Francesco2802/UniversalTouchFreeKeypadAdaptor/Schematic/Touch-Free Keypad Adaptor/Touch-Free Keypad Adaptor rev1.0/Touch-Free Keypad Adaptor rev1.0.sch

## EAGLE design Schematic/Touch-Free Keypad Adaptor/Touch-Free Keypad Adaptor rev1.0/Touch-Free Keypad Adaptor rev1.0.sch (2020-08-30)

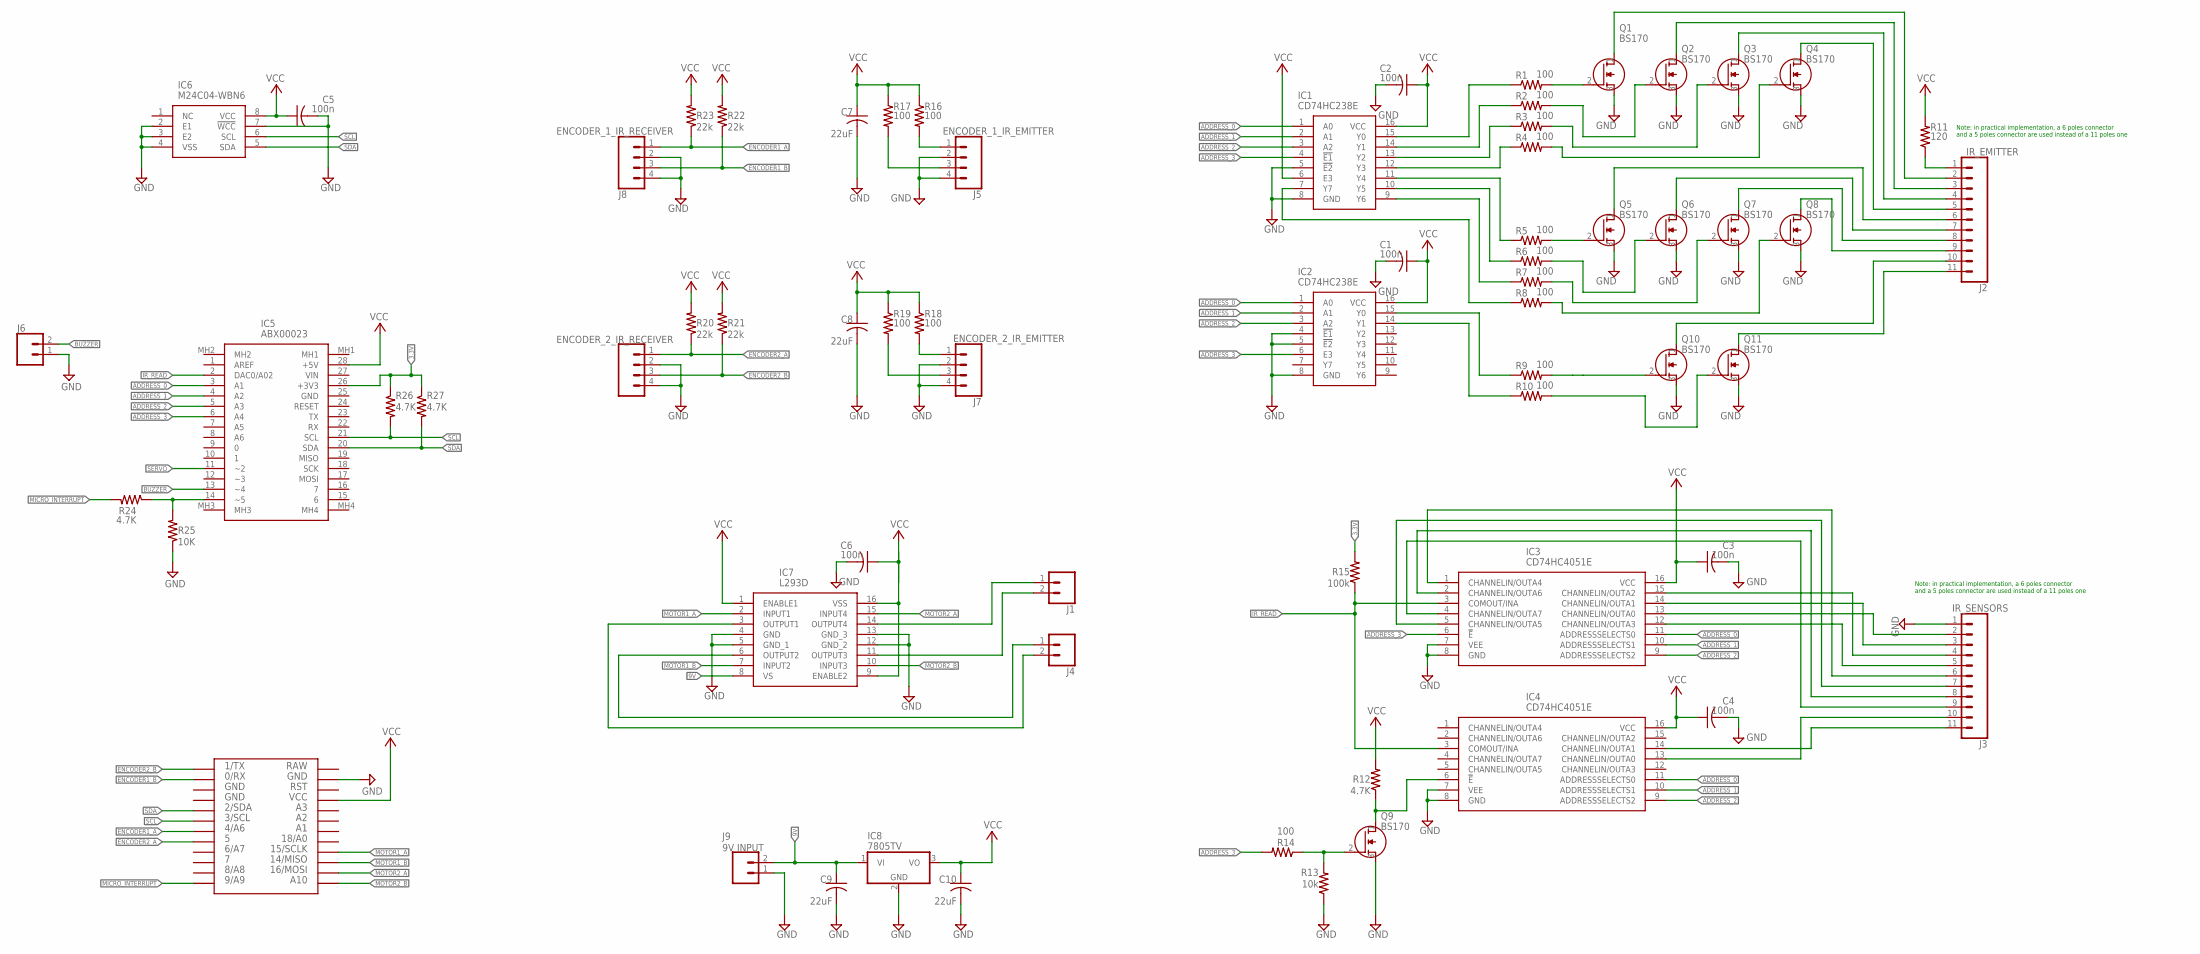
[picture p1: schematic Touch-Free Keypad Adaptor rev1.0.sch]

Parts:
C1, C2, C3, C4, C5, C6: 100n; C050-024X044
C7, C8, C9, C10: 22uF; C050-024X044
ENCODER_2_IR_RECEIVER: CONN_04; 1X04
IC1, IC2: CD74HC238E; DIP794W53P254L1930H508Q16N
IC3, IC4: CD74HC4051E; DIP794W53P254L1930H508Q16N
IC5: ABX00023
IC6: M24C04-WBN6; DIP762W56P254L959H533Q8N
IC7: L293D; DIP795W50P254L2000H510Q16N
IC8: 7805TV; TO220V
J1, J4, J6: CONN_02; 1X02
J2: IR_EMITTER; 1X11
J3: IR_SENSORS; 1X11
J5: ENCODER_1_IR_EMITTER; 1X04
J7: ENCODER_2_IR_EMITTER; 1X04
J8: ENCODER_1_IR_RECEIVER; 1X04
J9: 9V INPUT; SCREWTERMINAL-5MM-2
Q1, Q2, Q3, Q4, Q5, Q6, Q7, Q8, Q9, Q10, Q11: BS170; KA431AZTA
R1, R2, R3, R4, R5, R6, R7, R8, R9, R10, R14, R16, R17, R18, R19: 100; 0207/7
R11: 120; 0207/7
R12, R24, R26, R27: 4.7K; 0207/7
R13: 10k; 0207/7
R15: 100k; 0207/7
R20, R21, R22, R23: 22k; 0207/7
R25: 10K; 0207/7
U$31: ARDUINO_MICRO

Connections:
3.3V: IC5.26 (+3V3), R15.2, R26.1, R27.1
9V: C9.1, IC7.8 (VS), IC8.1 (VI), J9.2
ADDRESS_0: IC1.1 (A0), IC2.1 (A0), IC3.11 (ADDRESSSELECTS0), IC4.11 (ADDRESSSELECTS0), IC5.3 (A1)
ADDRESS_1: IC1.2 (A1), IC2.2 (A1), IC3.10 (ADDRESSSELECTS1), IC4.10 (ADDRESSSELECTS1), IC5.4 (A2)
ADDRESS_2: IC1.3 (A2), IC2.3 (A2), IC3.9 (ADDRESSSELECTS2), IC4.9 (ADDRESSSELECTS2), IC5.5 (A3)
ADDRESS_3: IC1.4 (!E1), IC2.6 (E3), IC3.6 (!E), IC5.6 (A4), R14.2
BUZZER: IC5.13 (~4), J6.2
ENCODER1_A: J8.1, R23.1, U$31.P$7
ENCODER1_B: J8.3, R22.1, U$31.P$2
ENCODER2_A: ENCODER_2_IR_RECEIVER.1, R20.1, U$31.P$8
ENCODER2_B: ENCODER_2_IR_RECEIVER.3, R21.1, U$31.P$1
GND: C1.2, C2.2, C3.2, C4.2, C5.2, C6.2, C7.2, C8.2, C9.2, C10.2, ENCODER_2_IR_RECEIVER.2, ENCODER_2_IR_RECEIVER.4, IC1.5 (!E2), IC1.8 (GND), IC2.4 (!E1), IC2.5 (!E2), IC2.8 (GND), IC3.7 (VEE), IC3.8 (GND), IC4.7 (VEE), IC4.8 (GND), IC6.2 (E1), IC6.3 (E2), IC6.4 (VSS), IC6.7 (!WCC), IC7.4 (GND), IC7.5 (GND_1), IC7.12 (GND_2), IC7.13 (GND_3), IC8.2 (GND), J3.1, J5.2, J5.4, J6.1, J7.2, J7.4, J8.2, J8.4, J9.1, Q1.3 (S), Q2.3 (S), Q3.3 (S), Q4.3 (S), Q5.3 (S), Q6.3 (S), Q7.3 (S), Q8.3 (S), Q9.3 (S), Q10.3 (S), Q11.3 (S), R13.1, R25.1, U$31.P$23
IR_READ: IC3.3 (COMOUT/INA), IC4.3 (COMOUT/INA), IC5.2 (DAC0/A02), R15.1
MICRO_INTERRUPT: R24.2, U$31.P$12
MOTOR1_A: IC7.2 (INPUT1), U$31.P$16
MOTOR1_B: IC7.7 (INPUT2), U$31.P$15
MOTOR2_A: IC7.15 (INPUT4), U$31.P$14
MOTOR2_B: IC7.10 (INPUT3), U$31.P$13
unnamed: J2.5, Q4.1 (D)
unnamed: J2.4, Q3.1 (D)
unnamed: J2.3, Q2.1 (D)
unnamed: J2.2, Q1.1 (D)
unnamed: J2.11, Q11.1 (D)
unnamed: J2.8, Q7.1 (D)
unnamed: J2.7, Q6.1 (D)
unnamed: J2.6, Q5.1 (D)
unnamed: J2.10, Q10.1 (D)
unnamed: J2.9, Q8.1 (D)
unnamed: Q4.2 (G), R4.2
unnamed: Q3.2 (G), R3.2
unnamed: Q2.2 (G), R2.2
unnamed: Q1.2 (G), R1.2
unnamed: Q5.2 (G), R5.2
unnamed: Q8.2 (G), R8.2
unnamed: Q7.2 (G), R7.2
unnamed: Q6.2 (G), R6.2
unnamed: Q10.2 (G), R9.2
unnamed: Q11.2 (G), R10.2
unnamed: IC1.15 (Y0), R1.1
unnamed: IC1.14 (Y1), R2.1
unnamed: IC1.13 (Y2), R3.1
unnamed: IC1.12 (Y3), R4.1
unnamed: IC1.11 (Y4), R5.1
unnamed: IC1.10 (Y5), R6.1
unnamed: IC1.9 (Y6), R7.1
unnamed: IC1.7 (Y7), R8.1
unnamed: IC2.15 (Y0), R9.1
unnamed: IC2.14 (Y1), R10.1
unnamed: J2.1, R11.1
unnamed: IC3.13 (CHANNELIN/OUTA0), J3.2
unnamed: IC3.14 (CHANNELIN/OUTA1), J3.3
unnamed: IC3.15 (CHANNELIN/OUTA2), J3.4
unnamed: IC3.12 (CHANNELIN/OUTA3), J3.5
unnamed: IC3.1 (CHANNELIN/OUTA4), J3.6
unnamed: IC3.5 (CHANNELIN/OUTA5), J3.7
unnamed: IC3.2 (CHANNELIN/OUTA6), J3.8
unnamed: IC3.4 (CHANNELIN/OUTA7), J3.9
unnamed: IC4.13 (CHANNELIN/OUTA0), J3.10
unnamed: IC4.14 (CHANNELIN/OUTA1), J3.11
unnamed: J7.1, R18.2
unnamed: IC4.6 (!E), Q9.1 (D), R12.1
unnamed: Q9.2 (G), R13.2, R14.1
unnamed: IC7.14 (OUTPUT4), J1.1
unnamed: IC7.11 (OUTPUT3), J1.2
unnamed: IC7.6 (OUTPUT2), J4.1
unnamed: IC7.3 (OUTPUT1), J4.2
unnamed: J5.1, R16.2
unnamed: J5.3, R17.2
unnamed: J7.3, R19.2
unnamed: IC5.14 (~5), R24.1, R25.2
SCL: IC5.21 (SCL), IC6.6 (SCL), R26.2, U$31.P$6
SDA: IC5.20 (SDA), IC6.5 (SDA), R27.2, U$31.P$5
SERVO: IC5.11 (~2)
VCC: C1.1, C2.1, C3.1, C4.1, C5.1, C7.1, C8.1, C10.1, IC1.6 (E3), IC1.16 (VCC), IC2.16 (VCC), IC3.16 (VCC), IC4.16 (VCC), IC5.28 (+5V), IC6.8 (VCC), IC7.1 (ENABLE1), IC7.9 (ENABLE2), IC7.16 (VSS), IC8.3 (VO), R11.2, R12.2, R16.1, R17.1, R18.1, R19.1, R20.2, R21.2, R22.2, R23.2, U$31.P$21
VCC1: C6.1

Notes on the sheet:
Note: in practical implementation, a 6 poles connector and a 5 poles connector are used instead of a 11 poles one
